MEPower/Moving_Tracking_Camera/(commit log)

2022-11-24 add arduino spinning servo code
2022-11-30 add another motors
2022-12-01 add third motor
2022-12-01 run all motors in parallel
2023-01-05 finish C++ rewrite (bugfixing still needed)
    [main.cpp]
2023-01-18 Connect to arduino and send values
2023-01-19 Receive frames from server
2023-01-19 fix all known bugs in C++ ObjectTracker
    [main.cpp]
2023-01-25 integrate arduino connection into C++ server
2023-01-26 c++: move serial connection into own thread
2023-02-02 make arduino listen to signals
2023-03-08 add servo controlling instructions
